ckemere/MiniStiMo-PCB/README.md

# Rodent DBS module PCBs

KiCAD design for a small scale constant current stimulator which can be controlled via BLE from a smartphone

Built Module
