ckemere/MiniStiMo-PCB/Manufacturing/rodentdbs/T-I6W552578A-20sets-BOM+-+Order+W552578ASI5(2023-09-12).xls

PCBWay Bom Quotation, Product No.:T-I6W552578A
Item # | *Designator | *Qty | Manufacturer | *Mfg Part # | Description / Value | *Package/Footprint | Mounting Type | Substitute | *Unit Price(20 sets) | *Total | *Delivery Time | *PCBWay Note | Customer Reply | PCBWay Update
1 | AE1 | 1 | Johanson Technology | 2450AT42B0100001E | RF ANT 2.4GHZ CHIP SOLDER SMD | SMD | SMD |  | $0.913 | $18.260 | 7-10 Workdays
2 | C1, C2, C3, C4, C5, C6, C7, C16 | 8 | Kyocera | 04023D104KAT2A | CAP CER 0.1UF 25V X5R 0402 | 0402 | SMD | Alternative MPN KGM05AR51E104KH | $0.041 | $6.560
3 | C8, C9 | 2 | Kyocera | 0402X105K160CT | CAP CER 1UF 16V X5R 0402 | 0402 | SMD |  | $0.011 | $0.440
4 | C10 | 1 | Kyocera | 04025A180JAT2A | CAP CER 18PF 50V C0G/NP0 0402 | 0402 | SMD | Alternative MPN KGM05ACG1H180JH | $0.013 | $0.260
5 | C11 | 1 | Kyocera | 04025A360JAT2A | CAP CER 36PF 50V NP0 0402 | 0402 | SMD |  | $0.092 | $1.840
6 | C12 | 1 | Kyocera | 04025C101KAT2A | CAP CER 100PF 50V X7R 0402 | 0402 | SMD | Alternative MPN KGM05AR71H101KH | $0.011 | $0.220
7 | C13, C14 | 2 | Kyocera | 06033D106MAT2A | CAP CER 10UF 25V X5R 0603 | 0603 | SMD | Alternative MPN KGM15CR51E106MT | $0.118 | $4.720
8 | C15 | 1 | Murata | GJM1555C1HR15BB01D | CAP CER 0.15PF 50V C0G/NP0 0402 | 0402 | SMD | High Q, RF | $0.106 | $2.120
9 | D1 | 1 | Wurth Electronik | 150040RS73240 | LED RED CLEAR 0402 SMD | 0402 | SMD |  | $0.412 | $8.240 | 7-10 Workdays
10 | D2 | 1 | Wurth Electronik | 150040VS73240 | LED GREEN CLEAR 0402 SMD | 0402 | SMD |  | $0.412 | $8.240 | 7-10 Workdays
11 | FB1, FB2 | 2 | Murata | BLM15AX221SN1D | FERRITE BEAD 220 OHM 0402 1LN | 0402 | SMD |  | $0.021 | $0.840
12 | IC1 | 1 | Analog Devices | MAX1724EZK50+T | IC REG BOOST 5V 400MA TSOT23-5 | TSOT-23-5 | SMD |  | $1.718 | $34.360
13 | J1 | 1 |  | DNP | Pin Header 1x5 1.27 mm |  |  | DNP |  |  |  | [DNP
14 | J2 | 1 |  | DNP | Pin Header 1x2 1.27 mm |  |  | DNP |  |  |  | [DNP
15 | J3 | 1 |  | DNP | Pin Header 1x2 2.54 mm |  |  | DNP |  |  |  | [DNP
16 | J4 | 1 |  | DNP | Pin Header 1x2 2.54 mm |  |  | DNP |  |  |  | [DNP
17 | L1 | 1 | Murata | 1277AS-H-100M=P2 | FIXED IND 10UH 900MA 420MOHM SMD | 1210 | SMD |  | $0.492 | $9.840 | 7-10 Workdays
18 | L2 | 1 | Murata | LQG15HS3N9S02D | FIXED IND 3.9NH 750MA 180MOHM SM | 0402 | SMD |  | $0.073 | $1.460 | 7-10 Workdays
19 | R1, R2 | 2 | Panasonic | ERJ-2GEJ331X | RES SMD 330 OHM 5% 1/10W 0402 | 0402 | SMD |  | $0.033 | $1.320 | 7-10 Workdays | qty 2？
20 | R3 | 1 | Panasonic | ERA-2VEB4701X | RES 4.7K OHM 0.1% 1/10W 0402 | 0402 | SMD |  | $0.272 | $5.440
21 | U2 | 2 | Infineon | CY8C4247LQI-BL493 | IC MCU 32BIT 128KB FLASH 56QFN | 56-QFN | SMD |  | $8.816 | $352.640 | 7-10 Workdays | qty 1？
22 | Y1 | 1 | ECS Inc. | ECS-.327-9-34B-C-TR | CRYSTAL 32.7680KHZ 9PF SMD | 2-SMD No Lead | SMD |  | $0.769 | $15.380 | 7-10 Workdays
23 | Y2 | 1 | ECS Inc. | ECS-240-8-33-RWY-TR | CRYSTAL 24.0000MHZ 8PF SMD | 4 SMD No Lead | SMD |  | $0.571 | $11.420 | 7-10 Workdays
 |  |  |  |  |  |  |  |  | Component Cost | $483.60
 |  |  |  |  |  |  |  |  | Assembly Cost | $88.00
 |  |  |  |  |  |  |  |  | PCB Cost | $66.11
 |  |  |  |  |  |  |  |  | V0 Member 0% off | $0.00
 |  |  |  |  |  |  |  |  | All Total 20 Sets | $637.71
