ckemere/MiniStiMo-PCB/Manufacturing/rodentdbs/BOM - Order W552578ASI5.xlsx

 |  |  | Order W552578ASI5 20 PCS BOM (Sample Bill of Materials)
Item # | *Designator | *Qty | Manufacturer | *Mfg Part # | Description / Value | *Package/Footprint | Type | Your Instructions / Notes
1 | AE1 | 1 | Johanson Technology | 2450AT42B0100001E | RF ANT 2.4GHZ CHIP SOLDER SMD | SMD | SMD
2 | C1, C2, C3, C4, C5, C6, C7, C16 | 8 | Kyocera | 04023D104KAT2A | CAP CER 0.1UF 25V X5R 0402 | 0402 | SMD | Alternative MPN KGM05AR51E104KH
3 | C8, C9 | 2 | Kyocera | 0402X105K160CT | CAP CER 1UF 16V X5R 0402 | 0402 | SMD
4 | C10 | 1 | Kyocera | 04025A180JAT2A | CAP CER 18PF 50V C0G/NP0 0402 | 0402 | SMD | Alternative MPN KGM05ACG1H180JH
5 | C11 | 1 | Kyocera | 04025A360JAT2A | CAP CER 36PF 50V NP0 0402 | 0402 | SMD
6 | C12 | 1 | Kyocera | 04025C101KAT2A | CAP CER 100PF 50V X7R 0402 | 0402 | SMD | Alternative MPN KGM05AR71H101KH
7 | C13, C14 | 2 | Kyocera | 06033D106MAT2A | CAP CER 10UF 25V X5R 0603 | 0603 | SMD | Alternative MPN KGM15CR51E106MT
8 | C15 | 1 | Murata | GJM1555C1HR15BB01D | CAP CER 0.15PF 50V C0G/NP0 0402 | 0402 | SMD | High Q, RF
9 | D1 | 1 | Wurth Electronik | 150040RS73240 | LED RED CLEAR 0402 SMD | 0402 | SMD
10 | D2 | 1 | Wurth Electronik | 150040VS73240 | LED GREEN CLEAR 0402 SMD | 0402 | SMD
11 | FB1, FB2 | 2 | Murata | BLM15AX221SN1D | FERRITE BEAD 220 OHM 0402 1LN | 0402 | SMD
12 | IC1 | 1 | Analog Devices | MAX1724EZK50+T | IC REG BOOST 5V 400MA TSOT23-5 | TSOT-23-5 | SMD
13 | J1 | 1 |  |  | Pin Header 1x5 1.27 mm |  |  | DNP
14 | J2 | 1 |  |  | Pin Header 1x2 1.27 mm |  |  | DNP
15 | J3 | 1 |  |  | Pin Header 1x2 2.54 mm |  |  | DNP
16 | J4 | 1 |  |  | Pin Header 1x2 2.54 mm |  |  | DNP
17 | L1 | 1 | Murata | 1277AS-H-100M=P2 | FIXED IND 10UH 900MA 420MOHM SMD | 1210 | SMD
18 | L2 | 1 | Murata | LQG15HS3N9S02D | FIXED IND 3.9NH 750MA 180MOHM SM | 0402 | SMD
19 | R1, R2 | 1 | Panasonic | ERJ-2GEJ331X | RES SMD 330 OHM 5% 1/10W 0402 | 0402 | SMD
20 | R3 | 1 | Panasonic | ERA-2VEB4701X | RES 4.7K OHM 0.1% 1/10W 0402 | 0402 | SMD
21 | U2 | 2 | Infineon | CY8C4247LQI-BL493 | IC MCU 32BIT 128KB FLASH 56QFN | 56-QFN | SMD
22 | Y1 | 1 | ECS Inc. | ECS-.327-9-34B-C-TR | CRYSTAL 32.7680KHZ 9PF SMD | 2-SMD No Lead | SMD
23 | Y2 | 1 | ECS Inc. | ECS-240-8-33-RWY-TR | CRYSTAL 24.0000MHZ 8PF SMD | 4 SMD No Lead | SMD
Need a quick and accurante quote? Need an efficient production? Please read SMT Ordering Necessary Files & Info in 1 minute. Thank you very much! (https://www.pcbway.com/smt_ordering_guide.html)
Click for Instructions on How to Create a BOM (https://www.pcbway.com/blog/PCB_Assembly/How_to_Build_a_BOM__Bill_Of_Materials_.html)
