ckemere/MiniStiMo-PCB/BAT-HLD-014-THM.step

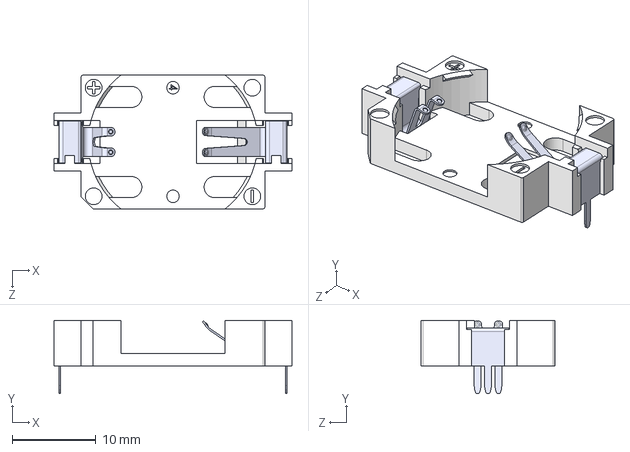
[picture p1: CAD file, 2023-10-25]
BAT-HLD-014-THM.step
28.5 x 8.80 x 16.0 mm
