ckemere/MiniStiMo-PCB/rodentdbs.kicad_pcb

## KiCad design rodentdbs.kicad_pcb (2023-10-25)

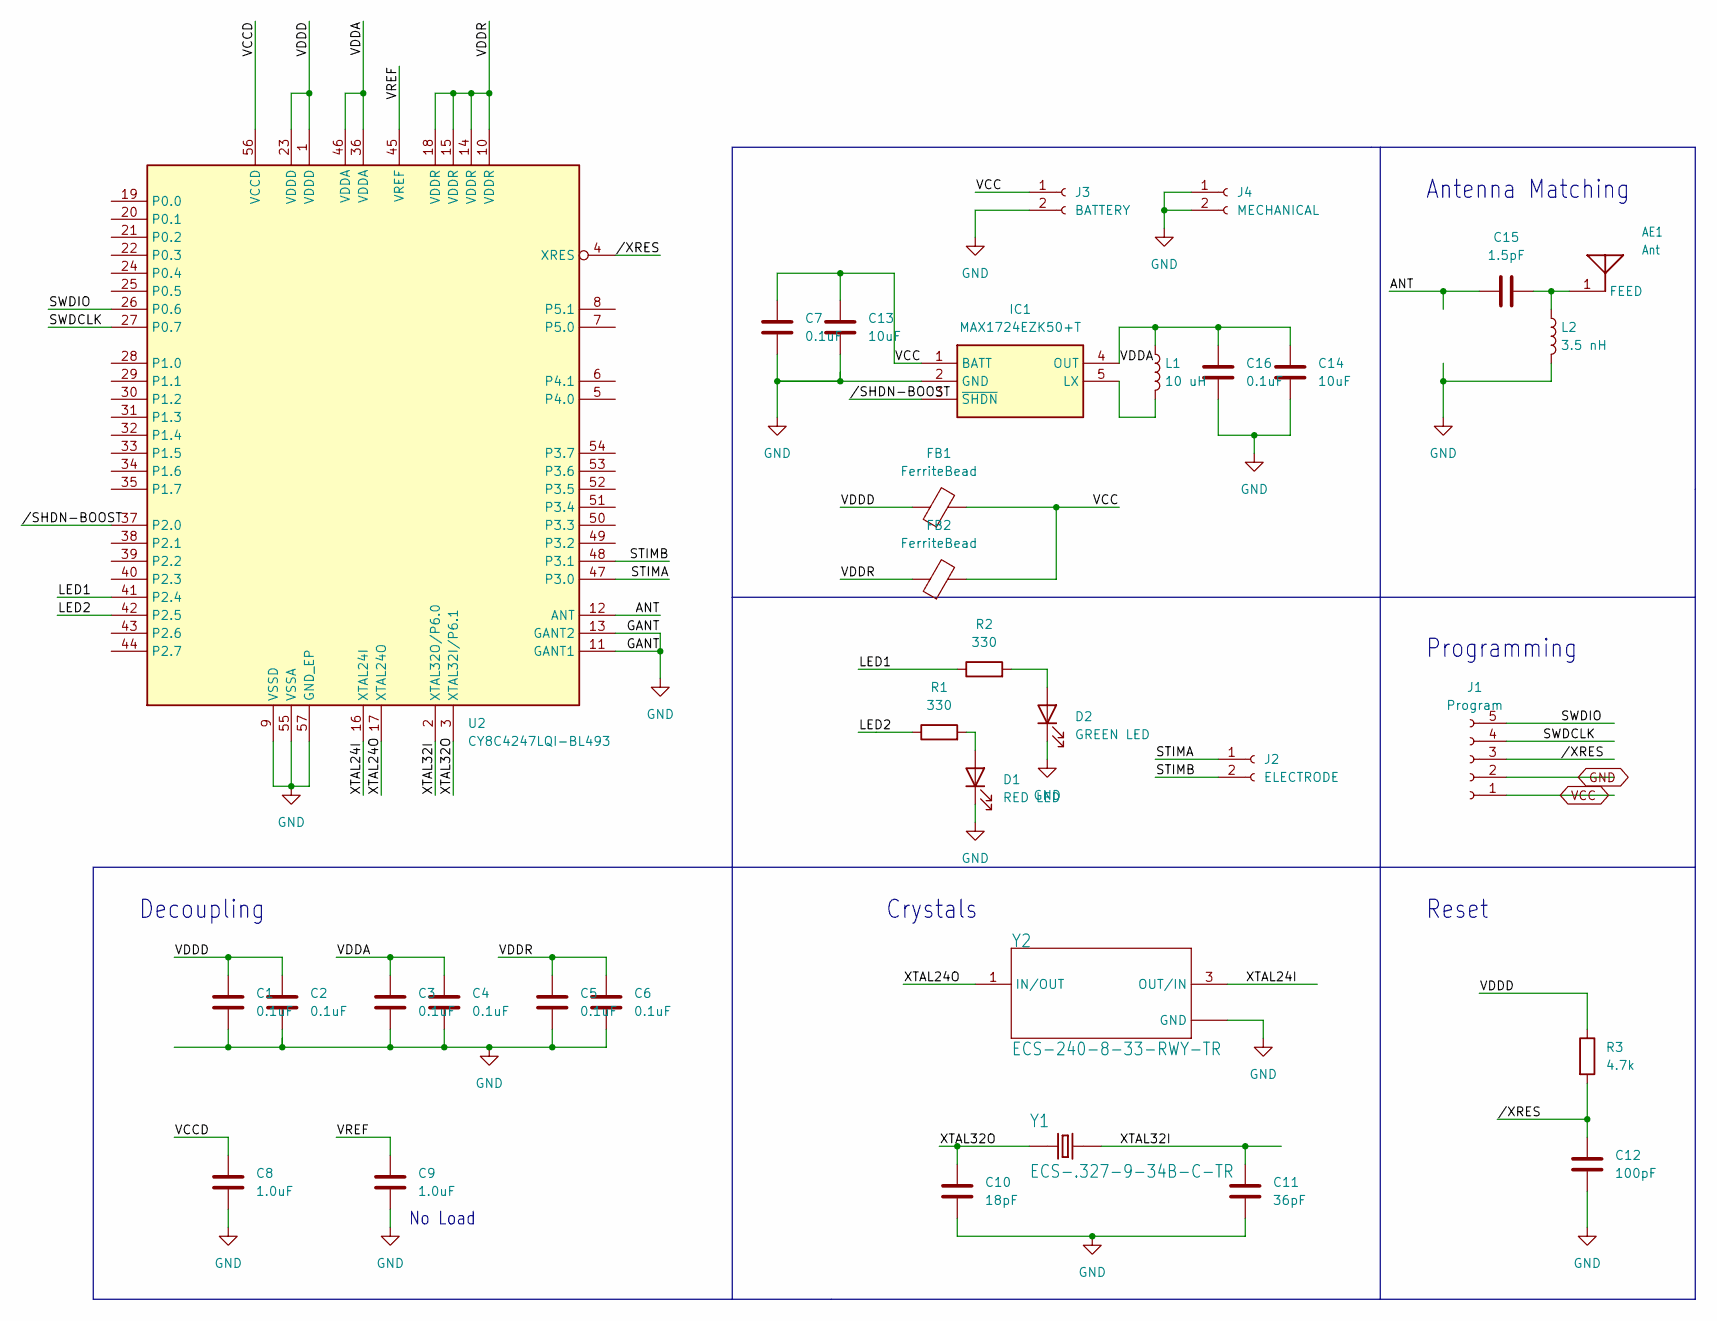
[picture p2: schematic rodentdbs_1.kicad_sch]

Parts:
AE1: Ant; XCVR_2450AT42B100E; Manufacturer_Part_Number 2450AT42B0100001E
C1, C2, C3, C4, C5, C6, C7, C16: 0.1uF; C_0402_1005Metric; Manufacturer_Part_Number 04023D104KAT2A
C8, C9: 1.0uF; C_0402_1005Metric; Manufacturer_Part_Number 0402X105K160CT
C10: 18pF; C_0402_1005Metric; Manufacturer_Part_Number 04025A180JAT2A
C11: 36pF; C_0402_1005Metric; Manufacturer_Part_Number 04025A360JAT2A
C12: 100pF; C_0402_1005Metric; Manufacturer_Part_Number 04025C101KAT2A
C13: 10uF; C_0603_1608Metric; Manufacturer_Part_Number 04026D106MAT2A
C14: 10uF; C_0603_1608Metric; Manufacturer_Part_Number 06033D106MAT2A
C15: 1.5pF; C_0402_1005Metric; Manufacturer_Part_Number GJM1555C1HR15BB01D
D1: RED LED; LED_0402_1005Metric; Manufacturer_Part_Number 150040RS73240
D2: GREEN LED; LED_0402_1005Metric; Manufacturer_Part_Number 150040VS73240
FB1, FB2: FerriteBead; L_0402_1005Metric; Manufacturer_Part_Number BLM15AX221SN1D
IC1: MAX1724EZK50+T; SOT95P275X110-5N; Mouser Part Number 700-MAX1724EZK50T
J1: Program; PinHeader_1x05_P1.27mm_Vertical
J2: ELECTRODE; PinHeader_1x02_P1.27mm_Vertical
J3: BATTERY; PinHeader_1x02_P2.54mm_Vertical
J4: MECHANICAL; PinHeader_1x02_P2.54mm_Vertical
L1: 10 uH; L_1210_3225Metric; Manufacturer_Part_Number 1277AS-H-100M=P2
L2: 3.5 nH; L_0402_1005Metric; Manufacturer_Part_Number LQG15HS3N9S02D
R1, R2: 330; R_0402_1005Metric; Manufacturer_Part_Number ERJ-2GEJ331X
R3: 4.7k; R_0402_1005Metric; Manufacturer_Part_Number ERA-2VEB4701X
U2: CY8C4247LQI-BL493; QFN-56-1EP_7x7mm_P0.4mm_EP5.6x5.6mm; Manufacturer_Part_Number CY8C4247LQI-BL493
Y1: ECS-.327-9-34B-C-TR; XTAL_ECS-.327-9-34B-C-TR; Manufacturer_Part_Number ECS-.327-9-34B-C-TR
Y2: ECS-240-8-33-RWY-TR; XTAL_ECS-240-8-33-RWY-TR; Manufacturer_Part_Number ECS-240-8-33-RWY-TR

Connections:
/rodentdbs_1/ANT: C15.1, U2.12 (ANT)
/rodentdbs_1/LED1: R2.1, U2.41 (P2.4)
/rodentdbs_1/LED2: R1.1, U2.42 (P2.5)
/rodentdbs_1/STIMA: J2.1, U2.47 (P3.0)
/rodentdbs_1/STIMB: J2.2, U2.48 (P3.1)
/rodentdbs_1/SWDCLK: J1.4, U2.27 (P0.7)
/rodentdbs_1/SWDIO: J1.5, U2.26 (P0.6)
/rodentdbs_1/VCCD: C8.1, U2.56 (VCCD)
/rodentdbs_1/VDDA: C3.1, C4.1, C14.1, C16.1, IC1.4 (OUT), L1.1, U2.36 (VDDA), U2.46 (VDDA)
/rodentdbs_1/VDDD: C1.1, C2.1, FB1.1, R3.1, U2.1 (VDDD), U2.23 (VDDD)
/rodentdbs_1/VDDR: C5.1, C6.1, FB2.1, U2.10 (VDDR), U2.14 (VDDR), U2.15 (VDDR), U2.18 (VDDR)
/rodentdbs_1/VREF: C9.1, U2.45 (VREF)
/rodentdbs_1/XTAL24I: U2.16 (XTAL24I), Y2.3 (OUT/IN)
/rodentdbs_1/XTAL24O: U2.17 (XTAL24O), Y2.1 (IN/OUT)
/rodentdbs_1/XTAL32I: C11.1, U2.2 (XTAL32O/P6.0), Y1.2
/rodentdbs_1/XTAL32O: C10.1, U2.3 (XTAL32I/P6.1), Y1.1
/rodentdbs_1//SHDN-BOOST: IC1.3 (~SHDN), U2.37 (P2.0)
GND: C1.2, C2.2, C3.2, C4.2, C5.2, C6.2, C7.2, C8.2, C9.2, C10.2, C11.2, C12.2, C13.2, C14.2, C16.2, D1.1 (K), D2.1 (K), IC1.2 (GND), J1.2, J3.2, J4.1, J4.2, L2.2, U2.9 (VSSD), U2.11 (GANT1), U2.13 (GANT2), U2.55 (VSSA), U2.57 (GND_EP), Y2.2 (GND), Y2.4 (GND)
unnamed: AE1.1 (FEED), C15.2, L2.1
unnamed: D1.2 (A), R1.2
unnamed: D2.2 (A), R2.2
unnamed: IC1.5 (LX), L1.2
VCC: C7.1, C13.1, FB1.2, FB2.2, IC1.1 (BATT), J1.1, J3.1

Notes on the sheet:
Programming
No Load
Crystals
Antenna Matching
Decoupling
Reset

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
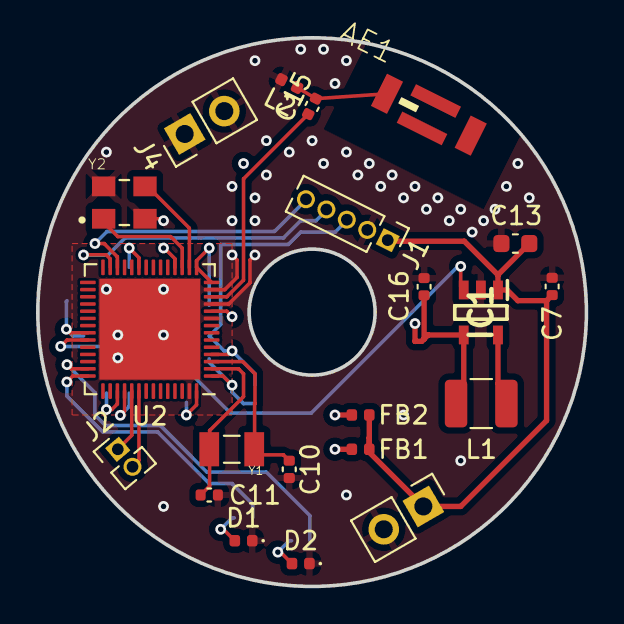
[picture p3: board rodentdbs.kicad_pcb from above]

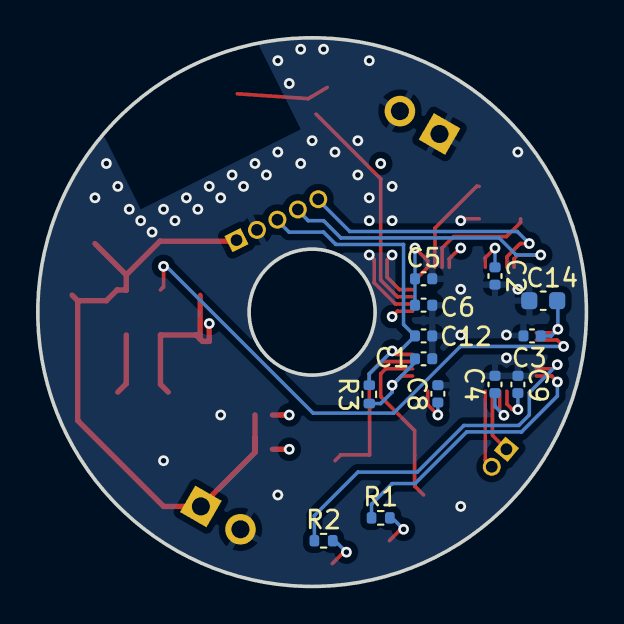
[picture p4: board rodentdbs.kicad_pcb from below]

Board: 4 copper layers, 30.5 x 30.5 mm, 34 parts (13 on the bottom side), 24 nets.
