ckemere/MiniStiMo-PCB/batterymodule.kicad_pcb

## KiCad design batterymodule.kicad_pcb (2023-10-25)

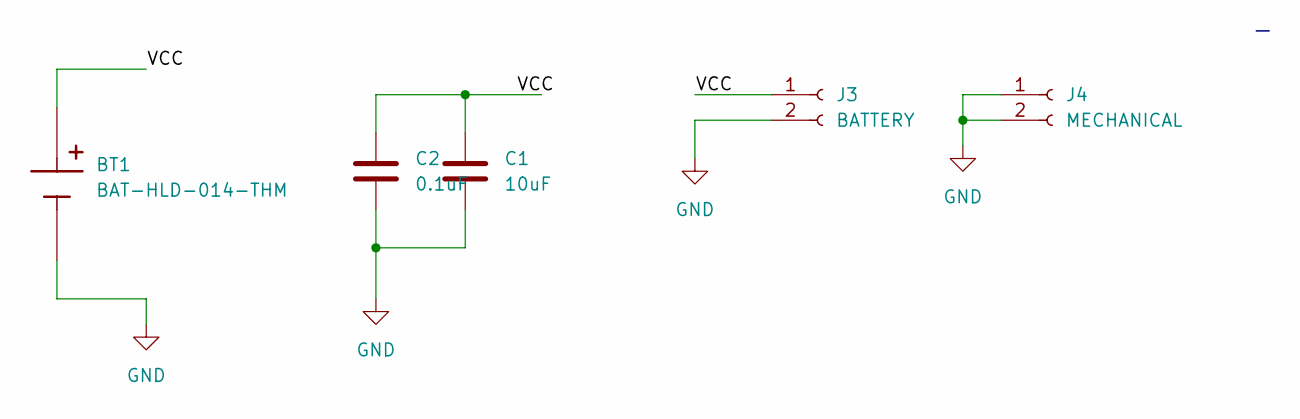
[picture p5: schematic batterymodule_1.kicad_sch]

Parts:
BT1: BAT-HLD-014-THM; BAT_BAT-HLD-014-THM
C1: 10uF; C_0603_1608Metric; Manufacturer_Part_Number 04026D106MAT2A
C2: 0.1uF; C_0402_1005Metric; Manufacturer_Part_Number 04023D104KAT2A
J3: BATTERY; PinHeader_1x02_P2.54mm_Vertical
J4: MECHANICAL; PinHeader_1x02_P2.54mm_Vertical

Connections:
/batterymodule_1/VCC: BT1.P_1, C1.1, C2.1, J3.1
GND: BT1.N, C1.2, C2.2, J3.2, J4.1, J4.2

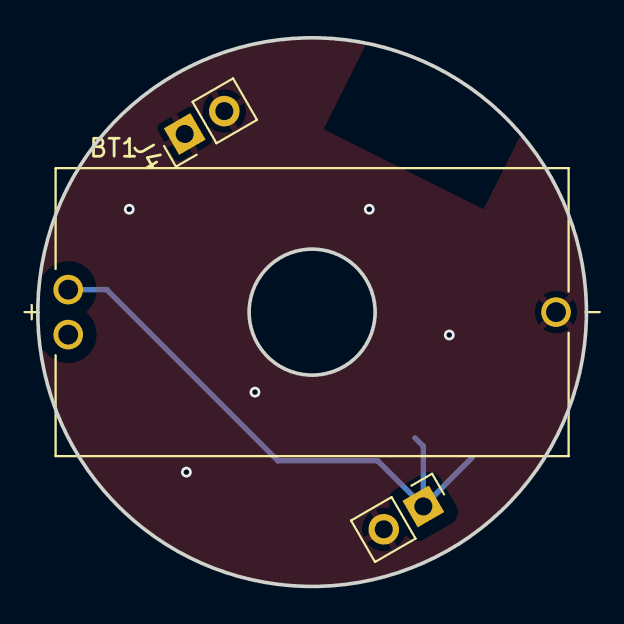
[picture p6: board batterymodule.kicad_pcb from above]

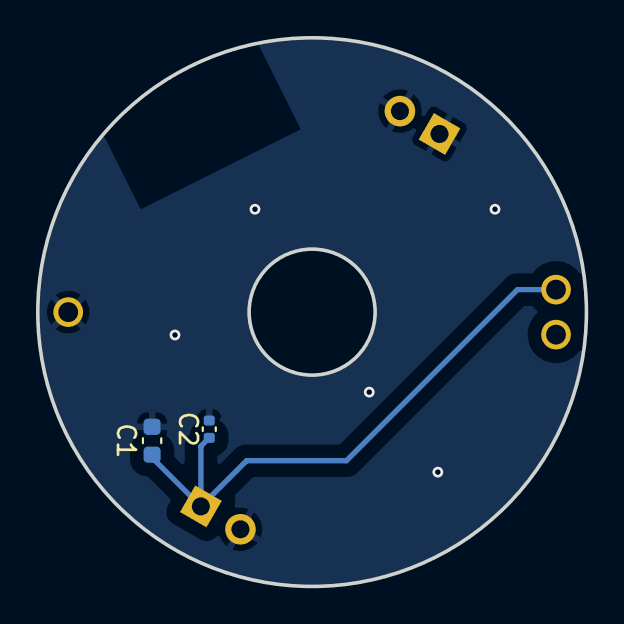
[picture p7: board batterymodule.kicad_pcb from below]

Board: 2 copper layers, 30.5 x 30.5 mm, 5 parts (2 on the bottom side), 2 nets.
