ckemere/MiniStiMo-PCB/(commit log)

2023-10-25 Fixed capacitor layout error in Rev 1.0 design
    [rodentdbs.kicad_pcb]
2023-10-25 Added BatteryModule PCB
    [BAT-HLD-014-THM.step, BOM - Order W552578ASI5.xlsx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]
2023-10-25 Updated directory structure and restored Manufacturing files
    [BOM - Order W552578ASI5.xlsx, T-I6W552578A-20sets-BOM+-+Order+W552578ASI5(2023-09-12).xls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]
